andrewromanenco/ESP32-S3-Flight-Controller/gerbers-and-bom/Gerbers/PCBWay_bom.csv

Designator | Quantity | Value | Footprint | Package | MPN | DNP | Mount_Type | Description | KiLib_Generator | Sim.Pins | DigiKey_Part_Number | SnapEDA_Link | Check_prices | STANDARD | PARTREV | MF | MP | MANUFACTURER | MAXIMUM_PACKAGE_HEIGHT | CREATOR | UNIT
+5.0 | 1 | 5-in | CONN_OSTVN02A150_OST |  |  |  | tht | Generic connector, single row, 01x02, script generated (kicad-library-utils/schlib/autogen/connector/)
C1 | 1 | 1uF | C_0603_1608Metric |  | CC0603KRX7R7BB105 |  | smt | CAP CER 1UF 16V X7R 0603 | SMD_2terminal_chip_molded
C10, C5 | 2 | 2.2uF | C_0603_1608Metric |  | CL10B225KP8NFNC |  | smt | Unpola2.2 µF ±10% 10V Ceramic Capacitor X7R 0603 (1608 Metric)rized capacitor | SMD_2terminal_chip_molded
C11, C6 | 2 | 100nF | C_0603_1608Metric |  | CL10B104KO8NNNC |  | smt | 100nF 16V X7R 0603 | SMD_2terminal_chip_molded
C2, C8 | 2 | 10uF | C_0805_2012Metric |  | CL21A106KPFNNNE |  | smt | CAP CER 10UF 10V X5R 0805 | SMD_2terminal_chip_molded
C3 | 1 | 10 uF | C_0805_2012Metric |  | CL21B106KOQNNNE |  | smt | CAP CER 10UF 16V X7R 0805 | SMD_2terminal_chip_molded
C4 | 1 | 22uF | C_1206_3216Metric |  | CL31B226KQHNNNE |  | smt | 22 µF ±10% 6.3V Ceramic Capacitor X7R 1206 (3216 Metric) | SMD_2terminal_chip_molded
C7 | 1 | 10nF | C_0603_1608Metric |  | CL10B103KO8WPNC |  | smt | CAP CER 10NF 16V X7R 0603 | SMD_2terminal_chip_molded
C9 | 1 | 10nF | C_0603_1608Metric |  | C0603C103K5RACTU |  | smt | CAP CER 10000PF 50V X7R 0603 | SMD_2terminal_chip_molded
D2 | 1 | LED | LED_0603_1608Metric |  | SML-D12U1WT86 |  | smt | Light emitting diode, RED | SMD_2terminal_chip_molded | 1=K 2=A
D3 | 1 | SMAJ6.0A | D_SMA |  | SMAJ6.0A |  | smt | 400W unidirectional Transient Voltage Suppressor, 6.0Vr, SMA(DO-214AC)
D4, D5 | 2 | SS34 | D_SMA |  | SS34LW |  | smt | 40V 3A Schottky Diode, SMA
J1 | 1 | Conn_01x05 | JST_GH_BM05B-GHS-TBT_1x05-1MP_P1.25mm_Vertical |  |  |  | smt | Generic connector, single row, 01x05, script generated (kicad-library-utils/schlib/autogen/connector/) | connector/SMD_single_row_plus_mounting_pad
J10 | 1 | Conn_01x02 | JST_GH_BM02B-GHS-TBT_1x02-1MP_P1.25mm_Vertical |  |  |  | smt | Generic connector, single row, 01x02, script generated (kicad-library-utils/schlib/autogen/connector/) | connector/SMD_single_row_plus_mounting_pad
J11, J8 | 2 | i2c | JST_GH_SM04B-GHS-TB_1x04-1MP_P1.25mm_Horizontal |  |  |  | smt | Generic connector, single row, 01x04, script generated (kicad-library-utils/schlib/autogen/connector/) | connector/SMD_single_row_plus_mounting_pad
J12 | 1 | uart2 | JST_GH_SM04B-GHS-TB_1x04-1MP_P1.25mm_Horizontal |  |  |  | smt | Generic connector, single row, 01x04, script generated (kicad-library-utils/schlib/autogen/connector/) | connector/SMD_single_row_plus_mounting_pad
J13 | 1 | 5v power | JST_GH_SM02B-GHS-TB_1x02-1MP_P1.25mm_Horizontal |  |  |  | smt | Generic connector, single row, 01x02, script generated (kicad-library-utils/schlib/autogen/connector/) | connector/SMD_single_row_plus_mounting_pad
J14 | 1 | uart0 | JST_GH_SM04B-GHS-TB_1x04-1MP_P1.25mm_Horizontal |  |  |  | smt | Generic connector, single row, 01x04, script generated (kicad-library-utils/schlib/autogen/connector/) | connector/SMD_single_row_plus_mounting_pad
J19, J3 | 2 | Conn_01x05 | JST_GH_SM05B-GHS-TB_1x05-1MP_P1.25mm_Horizontal |  |  |  | smt | Generic connector, single row, 01x05, script generated (kicad-library-utils/schlib/autogen/connector/) | connector/SMD_single_row_plus_mounting_pad
J2 | 1 | USB4105-GF-A | USB4105_GCT |  | USB4105-GF-A-120 |  | smt
J4, J5 | 2 | spi | JST_GH_SM06B-GHS-TB_1x06-1MP_P1.25mm_Horizontal |  |  |  | smt | Generic connector, single row, 01x06, script generated (kicad-library-utils/schlib/autogen/connector/) | connector/SMD_single_row_plus_mounting_pad
J6 | 1 | uart1 | JST_GH_SM04B-GHS-TB_1x04-1MP_P1.25mm_Horizontal |  |  |  | smt | Generic connector, single row, 01x04, script generated (kicad-library-utils/schlib/autogen/connector/) | connector/SMD_single_row_plus_mounting_pad
J7, J9 | 2 | i2c_sw | SolderJumper-2_P1.3mm_Bridged_RoundedPad1.0x1.5mm |  |  |  | tht | Generic connector, single row, 01x02, script generated (kicad-library-utils/schlib/autogen/connector/)
R1, R11, R12, R8 | 4 | 10k | R_0603_1608Metric |  | RM06F1002CT |  | smt | RES 10K OHM 1% 1/10W 0603 | SMD_2terminal_chip_molded
R10 | 1 | MICROSMD110F-2 | RESC3125X65N |  | MICROSMD110F-2 |  | smt
R13, R3, R4 | 3 | 0 | R_0603_1608Metric |  | RC0603JR-070RL |  | smt | 0 Ohms Jumper 0.1W, 1/10W Chip Resistor 0603 (1608 Metric) Moisture Resistant Thick Film | SMD_2terminal_chip_molded
R2 | 1 | 470 | R_0603_1608Metric |  | CRGCQ0603F470R |  | smt | Resistor | SMD_2terminal_chip_molded
R5, R9 | 2 | 4.7k | R_0603_1608Metric |  | RMCF0603FT4K70 |  | smt | Resistor, 4.7k | SMD_2terminal_chip_molded
R6, R7 | 2 | 5.1k | R_0603_1608Metric |  | RC0603FR-075K1L |  | smt | Resistor, 5.1k | SMD_2terminal_chip_molded
U1, U6 | 2 | B3U-1000P | B3U-1000P |  |  |  | smt
U2 | 1 | TPS73733DCQR | DCQ0006A |  | TPS73733DCQR |  | smt
U3 | 1 | LP5907MFX-3.3 | SOT-23-5 |  | LP5907MFX-3.3/NOPB |  | smt | 250-mA Ultra-Low-Noise Low-IQ LDO, 3.3V, SOT-23 | package/gullwing
U4 | 1 | ESP32-S3-WROOM-1-N16R8 | ESP32-S3-WROOM-1 |  | ESP32-S3-WROOM-1-N16R8 |  | smt | 2.4 GHz WiFi (802.11 b/g/n) and Bluetooth ® 5 (LE) module Built around ESP32S3 series of SoCs, Xtensa ® dualcore 32bit LX7 microprocessor Flash up to 16 MB, PSRAM up to 8 MB 36 GPIOs, rich set of peripherals Onboard PCB antenna
U5 | 1 | NUP2201MR6T1G | SOT95P275X110-6N | TSOP-6 ON Semiconductor | NUP2201MR6T1G |  | smt | NUP2201MR6T1G, Dual Uni-Directional TVS Diode Array, 500W, 6-Pin TSOP | ON Semiconductor NUP2201MR6T1G |  |  | NUP2201MR6T1GOSCT-ND | https://www.snapeda.com/parts/NUP2201MR6T1G/Onsemi/view-part/?ref=snap | https://www.snapeda.com/parts/NUP2201MR6T1G/Onsemi/view-part/?ref=eda | IPC 7351B | 5 | ON Semiconductor | NUP2201MR6T1G | ON SEMICONDUCTOR
U7 | 1 | ICM-42686-P | XDCR_ICM-42686-P | Package | ICM-42686-P |  | smt | Accelerometer, Gyroscope, 3 Axis Sensor I²C, I3C℠, SPI Output |  |  | 1428-ICM-42686-PCT-ND | https://www.snapeda.com/parts/ICM-42686-P/TDK/view-part/?ref=snap | https://www.snapeda.com/parts/ICM-42686-P/TDK/view-part/?ref=eda | Manufacturer Recommendations | 1.4 | TDK InvenSense | ICM-42686-P | TDK InvenSense | 0.97mm | ASHISH | mm
