andrewromanenco/ESP32-S3-Flight-Controller/ESP32-IMU.kicad_pcb

## KiCad design ESP32-IMU.kicad_pcb (2026-11-07)

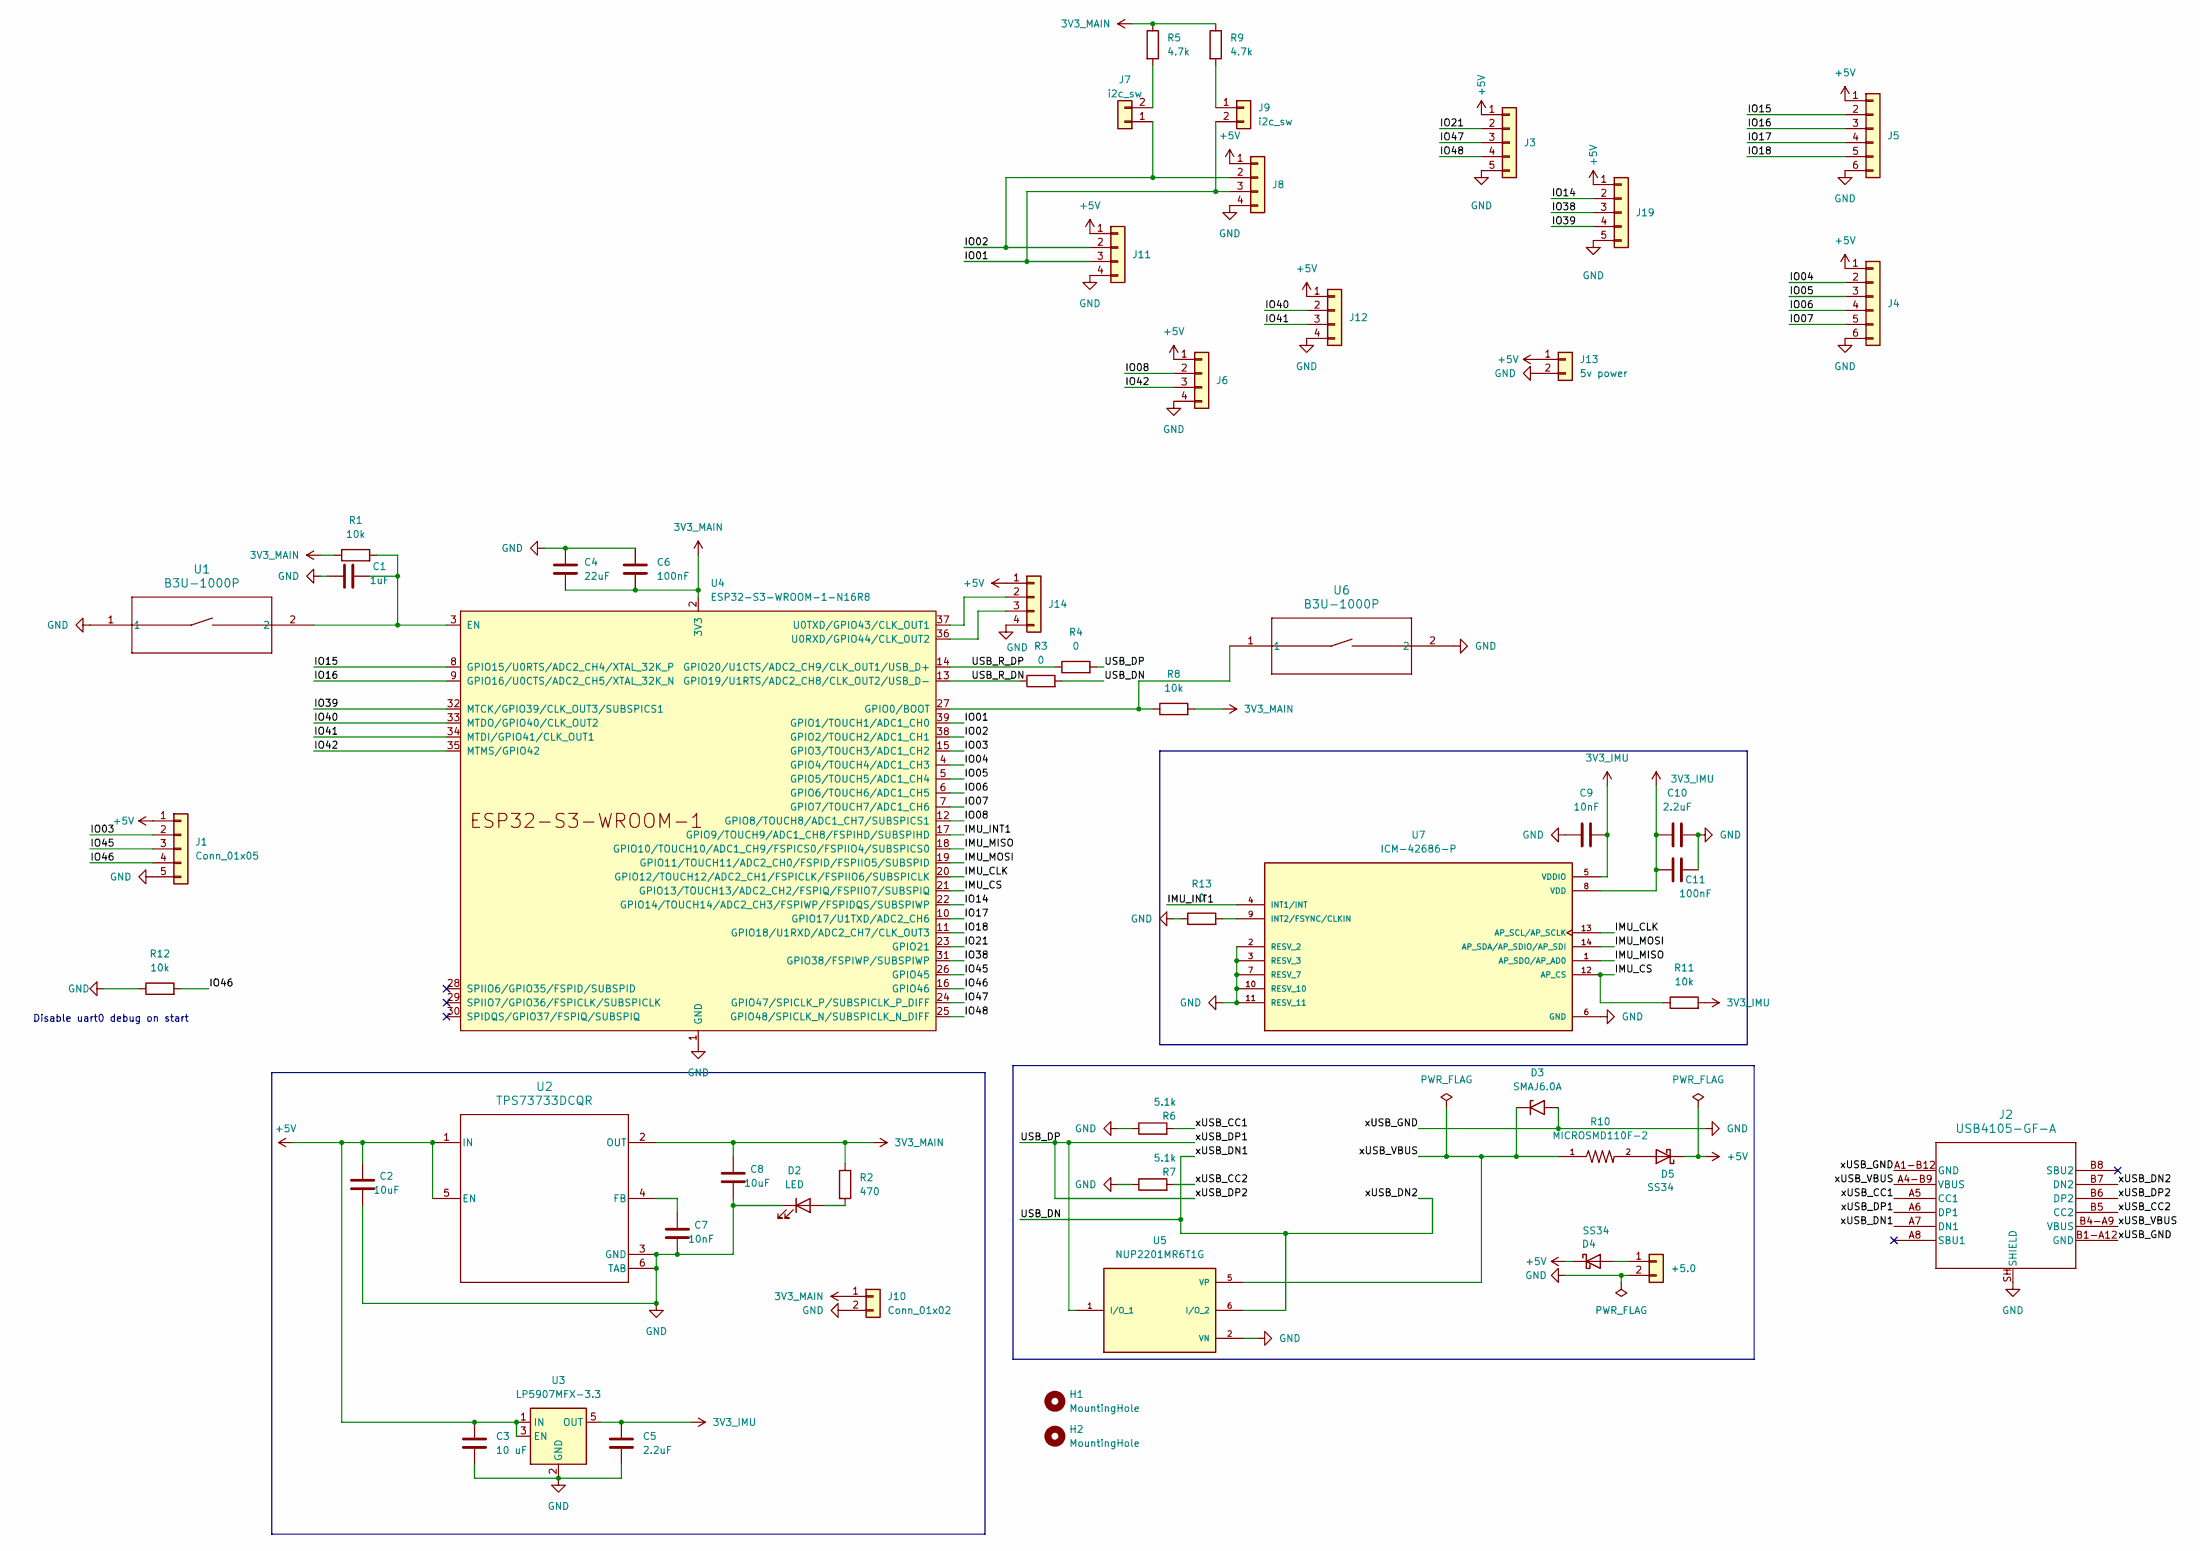
[picture p2: schematic ESP32-IMU.kicad_sch]

Parts:
+5.0: 5-in; CONN_OSTVN02A150_OST
C1: 1uF; C_0603_1608Metric; MPN CC0603KRX7R7BB105
C2, C8: 10uF; C_0805_2012Metric; MPN CL21A106KPFNNNE
C3: 10 uF; C_0805_2012Metric; MPN CL21B106KOQNNNE
C4: 22uF; C_1206_3216Metric; MPN CL31B226KQHNNNE
C5, C10: 2.2uF; C_0603_1608Metric; MPN CL10B225KP8NFNC
C6, C11: 100nF; C_0603_1608Metric; MPN CL10B104KO8NNNC
C7: 10nF; C_0603_1608Metric; MPN CL10B103KO8WPNC
C9: 10nF; C_0603_1608Metric; MPN C0603C103K5RACTU
D2: LED; LED_0603_1608Metric; MPN SML-D12U1WT86
D3: SMAJ6.0A; D_SMA; MPN SMAJ6.0A
D4, D5: SS34; D_SMA; MPN SS34LW
H1, H2: MountingHole; MountingHole_2.2mm_M2
J1: Conn_01x05; JST_GH_BM05B-GHS-TBT_1x05-1MP_P1.25mm_Vertical
J2: USB4105-GF-A; USB4105_GCT; MPN USB4105-GF-A-120
J3, J19: Conn_01x05; JST_GH_SM05B-GHS-TB_1x05-1MP_P1.25mm_Horizontal
J4, J5: spi; JST_GH_SM06B-GHS-TB_1x06-1MP_P1.25mm_Horizontal
J6: uart1; JST_GH_SM04B-GHS-TB_1x04-1MP_P1.25mm_Horizontal
J7, J9: i2c_sw; SolderJumper-2_P1.3mm_Bridged_RoundedPad1.0x1.5mm
J8, J11: i2c; JST_GH_SM04B-GHS-TB_1x04-1MP_P1.25mm_Horizontal
J10: Conn_01x02; JST_GH_BM02B-GHS-TBT_1x02-1MP_P1.25mm_Vertical
J12: uart2; JST_GH_SM04B-GHS-TB_1x04-1MP_P1.25mm_Horizontal
J13: 5v power; JST_GH_SM02B-GHS-TB_1x02-1MP_P1.25mm_Horizontal
J14: uart0; JST_GH_SM04B-GHS-TB_1x04-1MP_P1.25mm_Horizontal
R1, R8, R11, R12: 10k; R_0603_1608Metric; MPN RM06F1002CT
R2: 470; R_0603_1608Metric; MPN CRGCQ0603F470R
R3, R4, R13: 0; R_0603_1608Metric; MPN RC0603JR-070RL
R5, R9: 4.7k; R_0603_1608Metric; MPN RMCF0603FT4K70
R6, R7: 5.1k; R_0603_1608Metric; MPN RC0603FR-075K1L
R10: MICROSMD110F-2; RESC3125X65N; MPN MICROSMD110F-2
U1, U6: B3U-1000P
U2: TPS73733DCQR; DCQ0006A; MPN TPS73733DCQR
U3: LP5907MFX-3.3; SOT-23-5; MPN LP5907MFX-3.3/NOPB
U4: ESP32-S3-WROOM-1-N16R8; ESP32-S3-WROOM-1; MPN ESP32-S3-WROOM-1-N16R8
U5: NUP2201MR6T1G; SOT95P275X110-6N; PARTREV 5; DigiKey_Part_Number NUP2201MR6T1GOSCT-ND
U7: ICM-42686-P; XDCR_ICM-42686-P; PARTREV 1.4; DigiKey_Part_Number 1428-ICM-42686-PCT-ND

Connections:
3V3_IMU: C5.1, C9.2, C10.1, C11.2, R11.2, U3.5 (OUT), U7.5 (VDDIO), U7.8 (VDD)
3V3_MAIN: C4.2, C6.1, C8.2, J10.1, R1.1, R2.1, R5.1, R8.2, R9.1, U2.2 (OUT), U4.2 (3V3)
+5V: C2.2, C3.1, D4.1 (K), D5.1 (K), J1.1, J3.1, J4.1, J5.1, J6.1, J8.1, J11.1, J12.1, J13.1, J14.1, J19.1, U2.1 (IN), U2.5 (EN), U3.1 (IN), U3.3 (EN)
/IMU_CLK: U4.20 (GPIO12/TOUCH12/ADC2_CH1/FSPICLK/FSPIIO6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), U7.13 (AP_SCL/AP_SCLK)
/IMU_CS: R11.1, U4.21 (GPIO13/TOUCH13/ADC2_CH2/FSPIQ/FSPIIO7/S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), U7.12 (AP_CS)
/IMU_INT1: U4.17 (GPIO9/TOUCH9/ADC1_CH8/FSPIHD/SUBSPIHD), U7.4 (INT1/INT)
/IMU_MISO: U4.18 (GPIO10/TOUCH10/ADC1_CH9/FSPICS0/FSPIIO4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), U7.1 (AP_SDO/AP_AD0)
/IMU_MOSI: U4.19 (GPIO11/TOUCH11/ADC2_CH0/FSPID/FSPIIO5/S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), U7.14 (AP_SDA/AP_SDIO/AP_SDI)
/IO01: J8.3, J9.2, J11.3, U4.39 (GPIO1/TOUCH1/ADC1_CH0)
/IO02: J7.1, J8.2, J11.2, U4.38 (GPIO2/TOUCH2/ADC1_CH1)
/IO03: J1.2, U4.15 (GPIO3/TOUCH3/ADC1_CH2)
/IO04: J4.2, U4.4 (GPIO4/TOUCH4/ADC1_CH3)
/IO05: J4.3, U4.5 (GPIO5/TOUCH5/ADC1_CH4)
/IO06: J4.4, U4.6 (GPIO6/TOUCH6/ADC1_CH5)
/IO07: J4.5, U4.7 (GPIO7/TOUCH7/ADC1_CH6)
/IO08: J6.2, U4.12 (GPIO8/TOUCH8/ADC1_CH7/SUBSPICS1)
/IO14: J19.2, U4.22 (GPIO14/TOUCH14/ADC2_CH3/FSPIWP/FSPIDQS/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)
/IO15: J5.2, U4.8 (GPIO15/U0RTS/ADC2_CH4/XTAL_32K_P)
/IO16: J5.3, U4.9 (GPIO16/U0CTS/ADC2_CH5/XTAL_32K_N)
/IO17: J5.4, U4.10 (GPIO17/U1TXD/ADC2_CH6)
/IO18: J5.5, U4.11 (GPIO18/U1RXD/ADC2_CH7/CLK_OUT3)
/IO21: J3.2, U4.23 (GPIO21)
/IO38: J19.3, U4.31 (GPIO38/FSPIWP/SUBSPIWP)
/IO39: J19.4, U4.32 (MTCK/GPIO39/CLK_OUT3/SUBSPICS1)
/IO40: J12.2, U4.33 (MTDO/GPIO40/CLK_OUT2)
/IO41: J12.3, U4.34 (MTDI/GPIO41/CLK_OUT1)
/IO42: J6.3, U4.35 (MTMS/GPIO42)
/IO45: J1.3, U4.26 (GPIO45)
/IO46: J1.4, R12.2, U4.16 (GPIO46)
/IO47: J3.3, U4.24 (GPIO47/SPICLK_P/SUBSPICLK_P_DIFF)
/IO48: J3.4, U4.25 (GPIO48/SPICLK_N/SUBSPICLK_N_DIFF)
/USB_DN: J2.A7 (DN1), J2.B7 (DN2), R3.2, U5.6 (I/O_2)
/USB_DP: J2.A6 (DP1), J2.B6 (DP2), R4.2, U5.1 (I/O_1)
/USB_R_DN: R3.1, U4.13 (GPIO19/U1RTS/ADC2_CH8/CLK_OUT2/USB_D-)
/USB_R_DP: R4.1, U4.14 (GPIO20/U1CTS/ADC2_CH9/CLK_OUT1/USB_D+)
/xUSB_CC1: J2.A5 (CC1), R6.2
/xUSB_CC2: J2.B5 (CC2), R7.2
/xUSB_VBUS: D3.1 (A1), J2.A4-B9 (VBUS), J2.B4-A9 (VBUS), R10.1, U5.5 (VP)
GND: +5.0.2, C1.1, C2.1, C3.2, C4.1, C5.2, C6.2, C7.1, C8.1, C9.1, C10.2, C11.1, D2.1 (K), D3.2 (A2), J1.5, J2.A1-B12 (GND), J2.B1-A12 (GND), J2.SH (SHIELD), J3.5, J4.6, J5.6, J6.4, J8.4, J10.2, J11.4, J12.4, J13.2, J14.4, J19.5, R6.1, R7.1, R12.1, R13.1, U1.1, U2.3 (GND), U2.6 (TAB), U3.2 (GND), U4.1 (GND), U4.40 (GND), U4.41 (GND), U5.2 (VN), U6.2, U7.2 (RESV_2), U7.3 (RESV_3), U7.6 (GND), U7.7 (RESV_7), U7.10 (RESV_10), U7.11 (RESV_11)
unnamed: +5.0.1, D4.2 (A)
unnamed: D2.2 (A), R2.2
unnamed: D5.2 (A), R10.2
unnamed: J7.2, R5.2
unnamed: J9.1, R9.2
unnamed: J14.2, U4.37 (U0TXD/GPIO43/CLK_OUT1)
unnamed: J14.3, U4.36 (U0RXD/GPIO44/CLK_OUT2)
unnamed: C7.2, U2.4 (FB)
unnamed: C1.2, R1.2, U1.2, U4.3 (EN)
unnamed: R8.1, U4.27 (GPIO0/BOOT), U6.1
unnamed: R13.2, U7.9 (INT2/FSYNC/CLKIN)

Notes on the sheet:
Disable uart0 debug on start

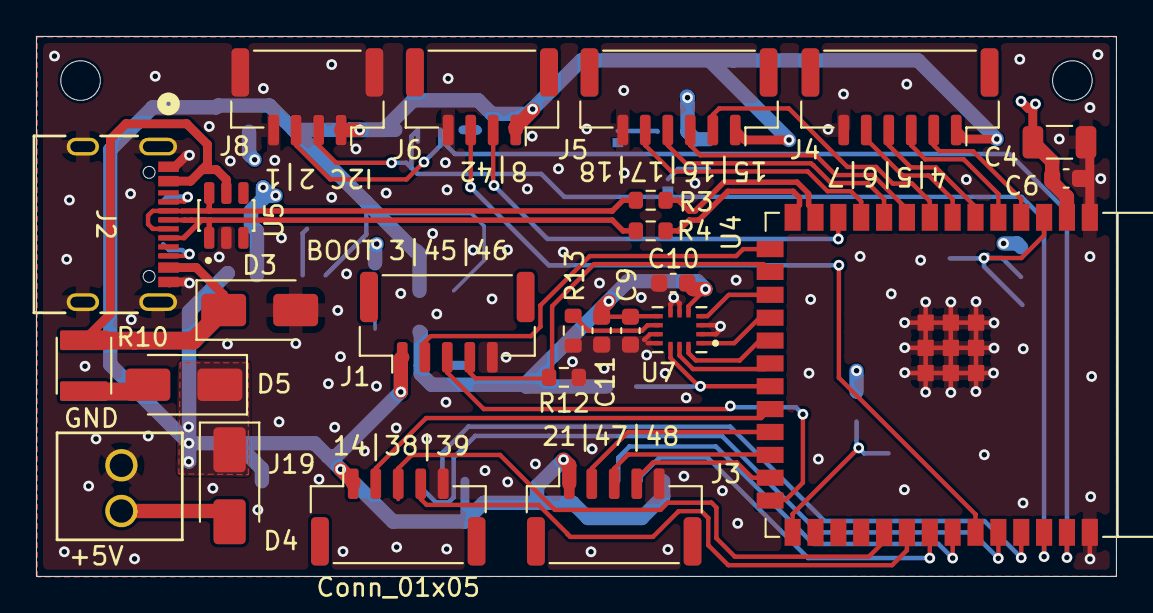
[picture p3: board ESP32-IMU.kicad_pcb from above]

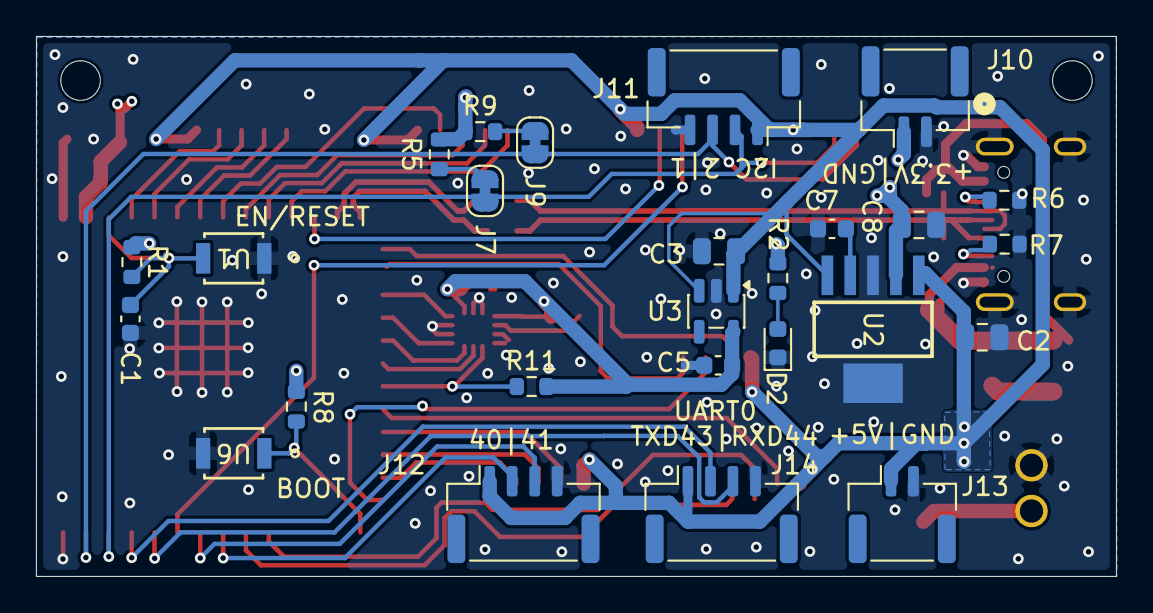
[picture p4: board ESP32-IMU.kicad_pcb from below]

Board: 4 copper layers, 60.0 x 30.0 mm, 53 parts (26 on the bottom side), 50 nets.
