andrewromanenco/ESP32-S3-Flight-Controller/(commit log)

2026-11-07 Import kicad files
    [ESP32-IMU.csv, ESP32-IMU.kicad_pcb, ESP32-IMU.kicad_sch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]
2026-11-07 Gerbers and OM
    [ESP32-IMU-B_Cu.gbr, ESP32-IMU-B_Mask.gbr, ESP32-IMU-B_Paste.gbr, ESP32-IMU-B_SilkS.gbr, ESP32-IMU-Edge_Cuts.gbr, ESP32-IMU-F_Cu.gbr, ESP32-IMU-F_Mask.gbr, ESP32-IMU-F_Paste.gbr]
